Guidin9/onair-ble/hardware/enclosure/onair_backplate_mirrored.stl

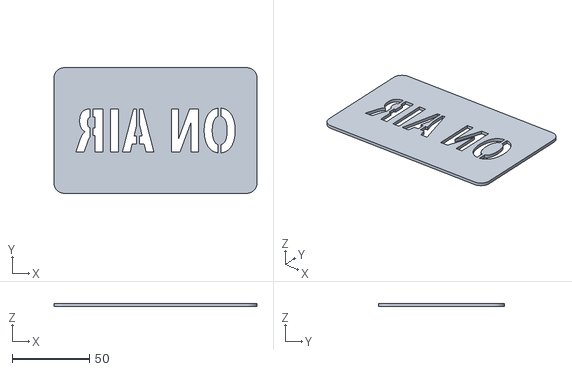
[picture p3: CAD file, 2026-10-20]
hardware/enclosure/onair_backplate_mirrored.stl
131.2 x 81.2 x 2.00
