Guidin9/onair-ble/hardware/enclosure/v1/onair_box_body_border_midpoint.stl

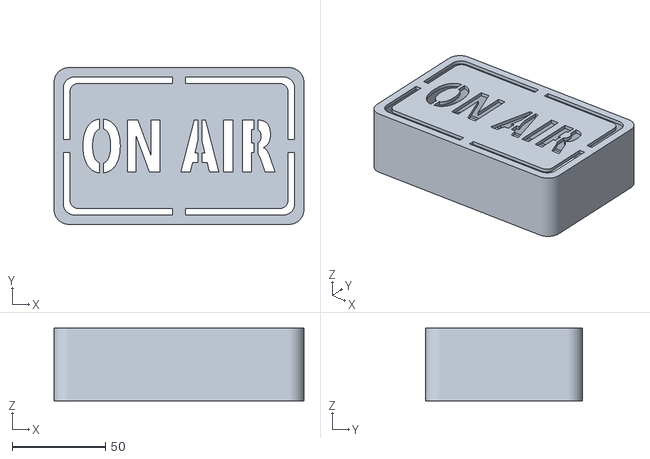
[picture p4: CAD file, 2026-10-20]
hardware/enclosure/v1/onair_box_body_border_midpoint.stl
134.0 x 84.0 x 39.0
