Guidin9/onair-ble/hardware/enclosure/onair_separator_bar.stl

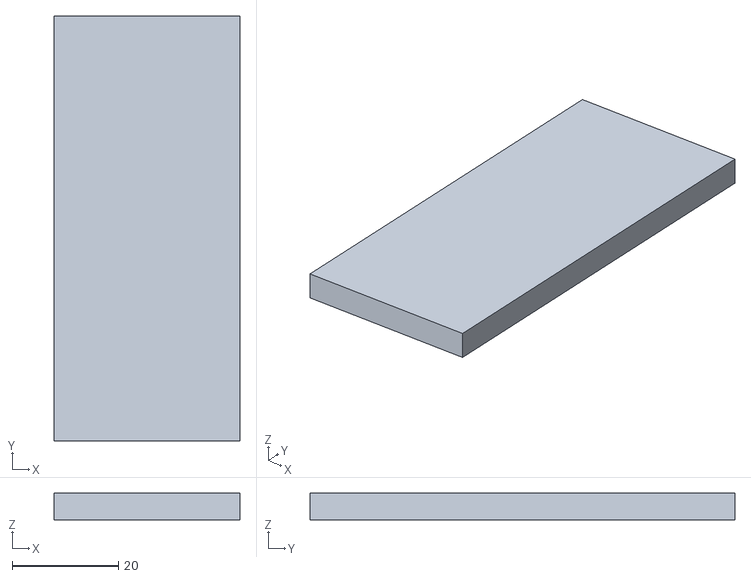
[picture p5: CAD file, 2026-10-20]
hardware/enclosure/onair_separator_bar.stl
35.0 x 80.0 x 5.00
