Guidin9/onair-ble/hardware/enclosure/v1/onair_backplate.stl

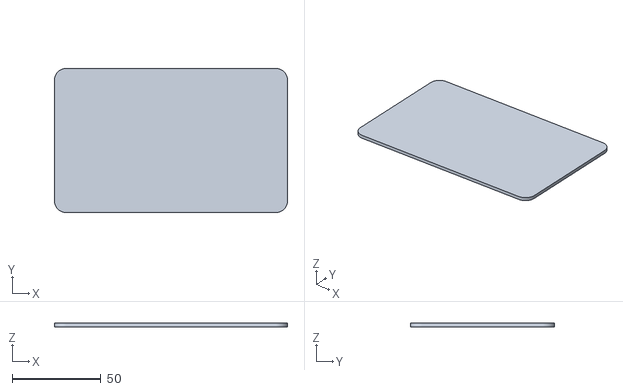
[picture p6: CAD file, 2026-10-20]
hardware/enclosure/v1/onair_backplate.stl
131.2 x 81.2 x 2.00
