Guidin9/onair-ble/hardware/enclosure/onair_logo_emboss.stl

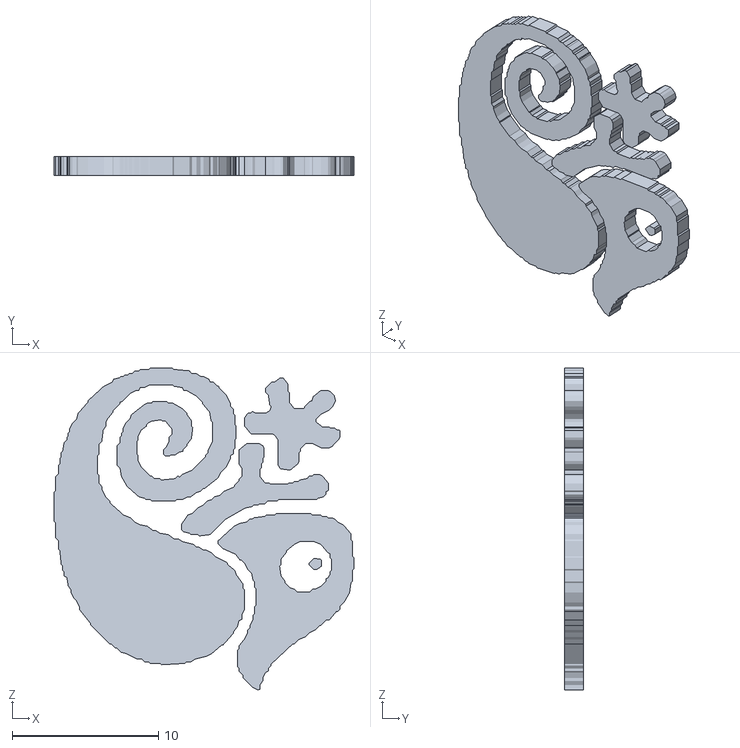
[picture p7: CAD file, 2026-10-20]
hardware/enclosure/onair_logo_emboss.stl
20.5 x 1.30 x 22.0
