Guidin9/onair-ble/hardware/enclosure/onair_box_body_border_midpoint.stl

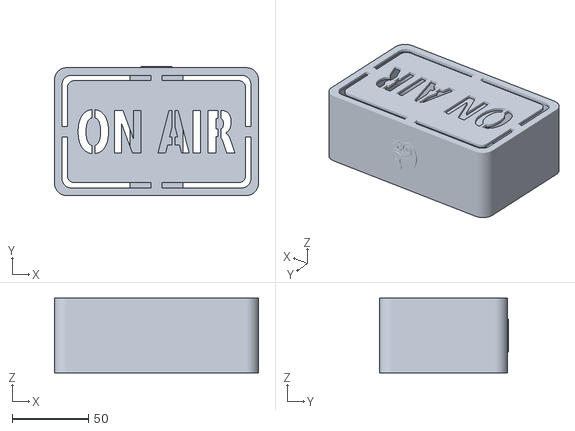
[picture p8: CAD file, 2026-10-20]
hardware/enclosure/onair_box_body_border_midpoint.stl
134.0 x 84.8 x 49.0
