Guidin9/onair-ble/(list of files, cad)

Other CAD files:
hardware/enclosure/onair_backplate.stl
