Guidin9/onair-ble/(commit log)

2026-10-20 On Air: Windows BLE app, ESP32-C3 firmware and 3D-printed enclosure
    - windows/: .NET 10 tray app that mirrors camera/mic use over BLE
    - firmware/: ESP32-C3 firmware (NimBLE) and an LED bring-up sketch
    - hardware/enclosure/: STL parts, plus the first revision under v1/
    - README in English and Turkish with wiring, parts, power budget and GATT contract
2026-10-20 Re-render enclosure images with three.js (fixes face-order artifacts)
